MonitorComputing/irdet/doc/amplifier veroboard 1.jpg

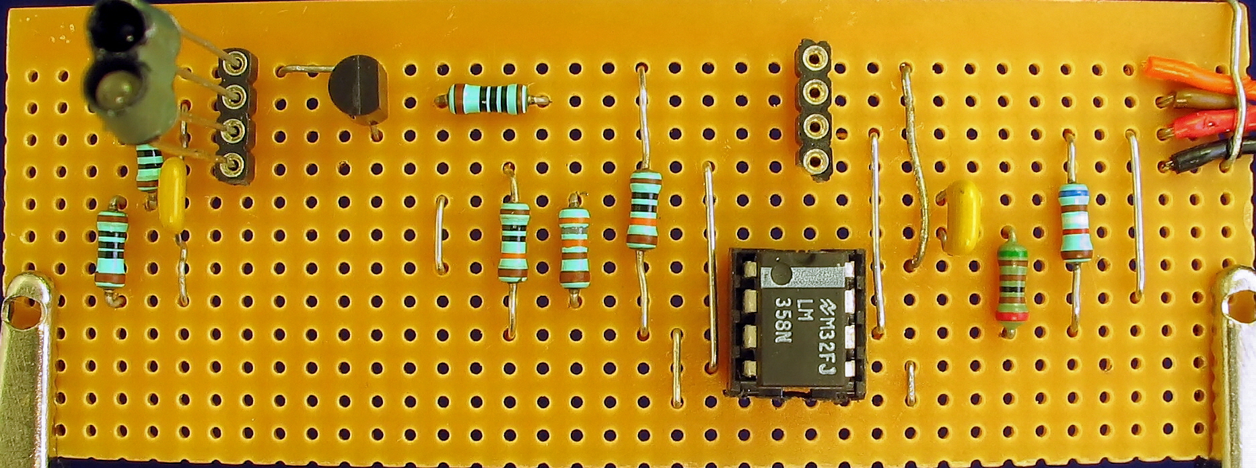
doc/amplifier veroboard 1.jpg
