MonitorComputing/irdet/doc/amplifier veroboard 2.jpg

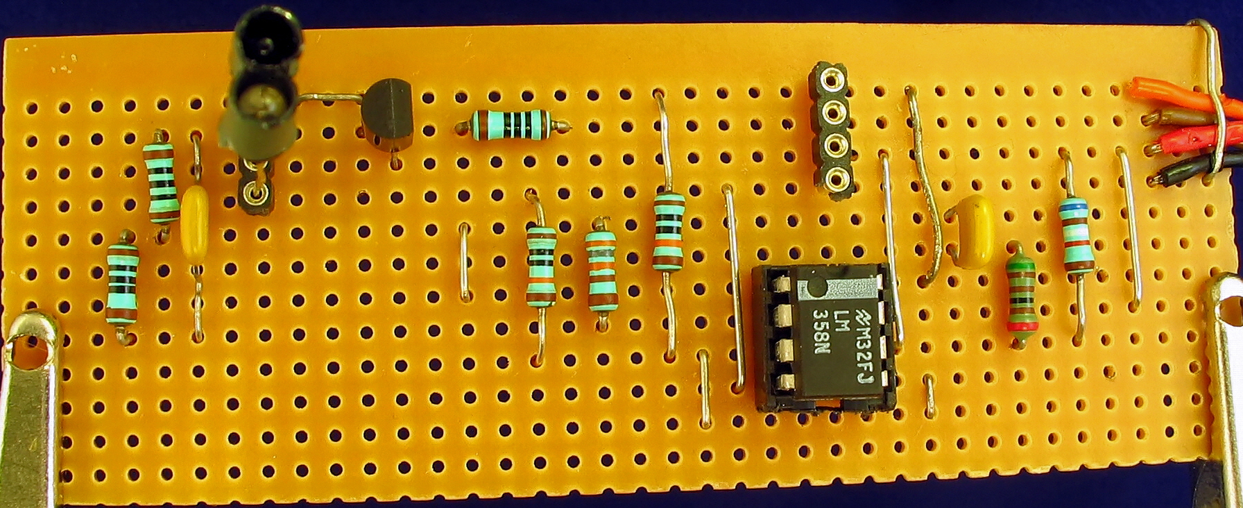
doc/amplifier veroboard 2.jpg
