MonitorComputing/irdet/README.md

# Overview
Microchip PIC microcontrollers High frequency pulsed Infra-Red reflective train detector utilising PIC monitor interface via full duplex serial link.

Written in Microchip MPASM assembly languge and built as MPLABX projects.

[Original web page for the project](https://monitor-computing.co.uk/projects/bodnet/index.htm)
# Dependency
Requires [utility_pic](https://github.com/MonitorComputing/utility_pic).
# License
This work is licensed under a [Creative Commons Attribution-NonCommercial-ShareAlike 4.0 International License][cc-by-nc-sa].

[][cc-by-nc-sa]
[][cc-by-nc-sa]

[cc-by-nc-sa]: http://creativecommons.org/licenses/by-nc-sa/4.0/
[cc-by-nc-sa-image]: https://licensebuttons.net/l/by-nc-sa/4.0/88x31.png
[cc-by-nc-sa-shield]: https://img.shields.io/badge/License-CC%20BY--NC--SA%204.0-lightgrey.svg
