MonitorComputing/irdet/doc/aird567/irdet12.bmp

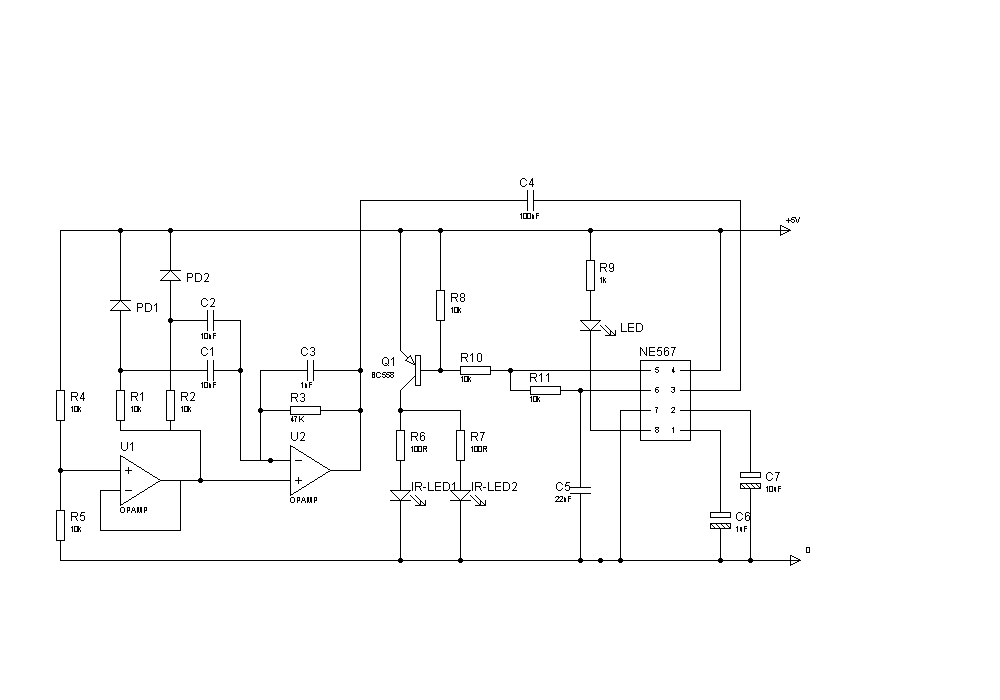
doc/aird567/irdet12.bmp
