MonitorComputing/irdet/doc/aird567/mail1.gif

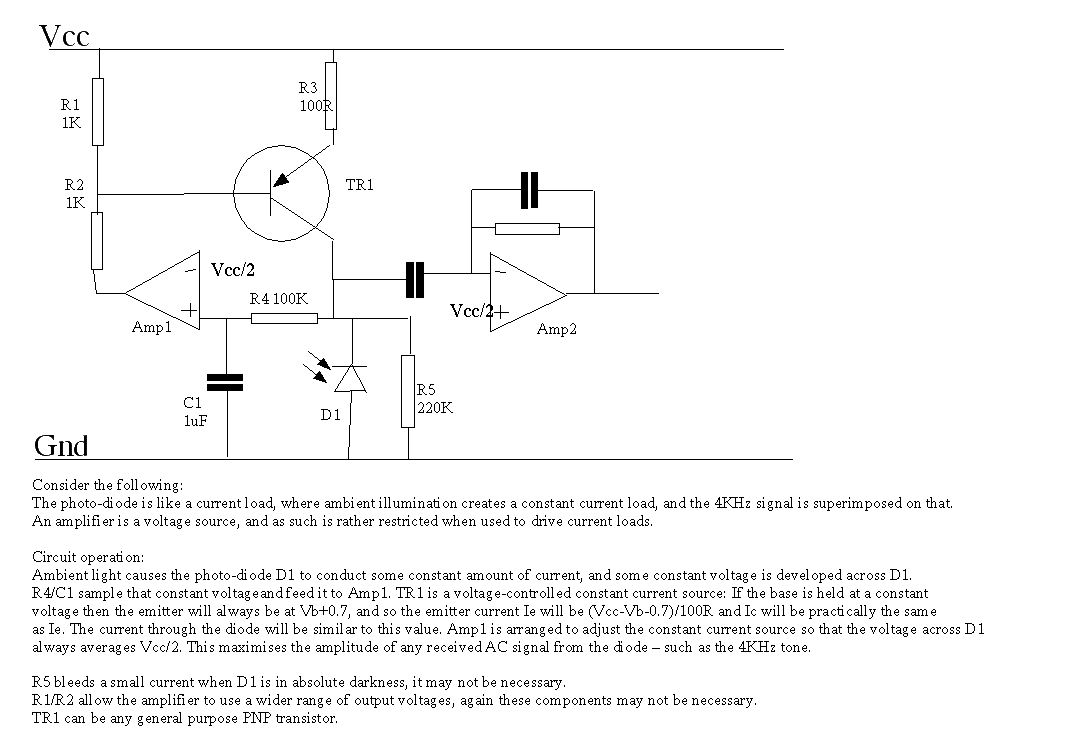
doc/aird567/mail1.gif
