MonitorComputing/irdet/doc/aird567/mail2.gif

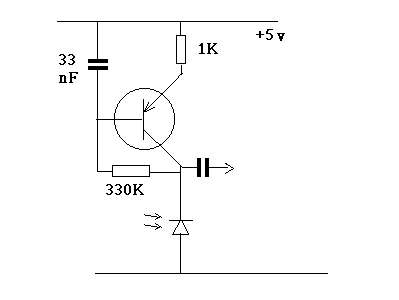
doc/aird567/mail2.gif
