MonitorComputing/irdet/doc/trace detecting.jpg

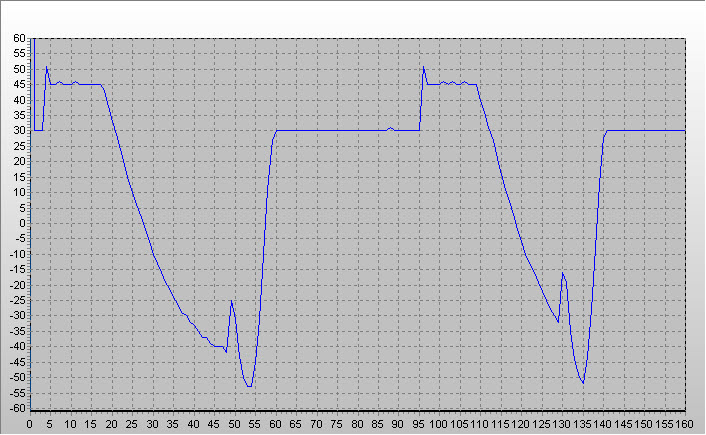
doc/trace detecting.jpg
