MonitorComputing/irdet/doc/trace not detecting.jpg

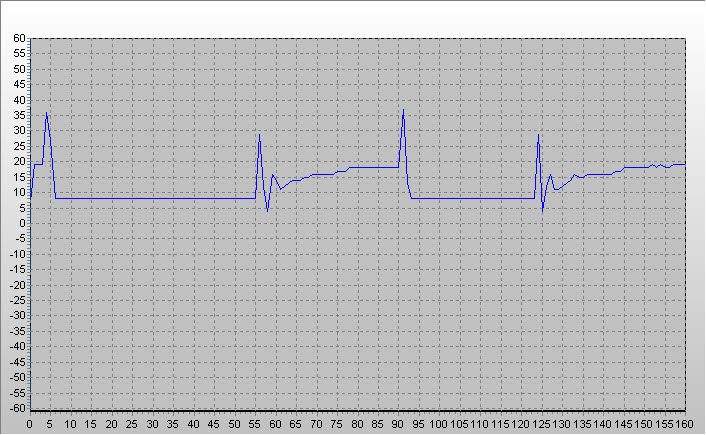
doc/trace not detecting.jpg
