MonitorComputing/irdet/(list of files, drawings)

Other design files:
doc/aird567.dsn
doc/amplifier assembly.dsn
