MonitorComputing/irdet/(commit log)

2005-05-22 Initial version, plain detection using single sensor.
2005-05-23 Change strategy from sensor state correspondance to transition correspondance.
2005-05-23 Corrected spelling of Revision keyword.
    [irdet.asm]
2011-03-02 Initial import to CVS.
    [amplifier assembly.dsn]
2011-03-12 First trial of IR amplifier Veroboard layout.
    [amplifier assembly.dsn]
2011-03-13 Added connector for slave amplifier.
2011-03-13 Mechanical assembly details for head to hold emiter and sensor.
2011-03-13 Updated Veroboard with connector for slave amplifier and note about wiring an amplifier as a slave.
2011-03-14 Added photo of prototype Veroboard.
2014-06-15 Corrected TO92 pin numbering.
    [amplifier assembly.dsn]
2015-01-31 Initial versions.
    [aird567.dsn]
2017-10-07 Switched to utility as a submodule. Created MPLAB X project.
    [Tone Filter.XLS]
2021-07-30 New version of MPLabX. Pulled utilities to current head of master.
